helmutheinz2002/analogevse/BOM.ods

AnalogEVSE BOM 1.7
Wert | Bauteile | Anzahl
5n6 | C1 | 1 | X
100n | C2,C5,C6,C8 | 4 | X
220n | C7 | 1 | X
330u/35V | C3,C4 | 2 | X
1u/16V | C9 | 1 | --
1k | R10,R18 | 2 | X
1k/1W | R9 | 1 | --
1k5 | R3 | 1 | X
2k2 | R16,R22 | 2 | X
2k7 | R15 | 1 | X
3k3 | R14 | 1 | X
4k7 | R23,R24,R25 | 3 | X
5k6 | R1 | 1 | --
10k | R2,R6,R7,R8,R11,R21 | 6 | X
15k | R17 | 1 | X
47k | R19,R27 | 2 | X
100k | R4,R5,R20,R26 | 4 | X
1M | R12,R13 | 2 | X
Trimmer 100k | RV1 | 1 | --
Feinsicherung 100mA | F1 | 1 | --
Sicherungshalter | F1 | 1 | --
Relais | K1 | 1 | --
Anschlussklemme 2 Pin | P1,P2,P3,P4,P5 | 5 | X
Anschlussklemme 3 Pin | P6,P7,P8 | 2 | X
Trafo 12V | T1 | 1 | --
DIP 14 Sockel | U1,U4 | 2 | X
1n4002 | D1,D2 | 2 | X
1n4148 | D3,D4,D5,D6,D7,D8 | 6 | X
SD101C | D9 | 1 | X
BC337-40 | Q1,Q2,Q4 | 3 | X
BC557 | Q3 | 1 | X
LM2901 | U1,U4 | 2 | X
LM7812 | U2 | 1 | X
LM7912 | U3 | 1 | X
 |  | 67
