helmutheinz2002/analogevse/Partslist.xls

Bauteile AnalogEVSE
Gesamt: |  | 17.19 |  |  | 18.619 |  | 15.724
Teil | Pollin | Einzelpreis | Info | Reichelt | Einzelpreis | Info | Minimum
P1 | 450 856 | 0.150 |  | AKL 055-02 | 0.310 |  | 0.150
P2 | 450 856 | 0.150 |  | AKL 055-02 | 0.310 |  | 0.150
P3 | 450 856 | 0.150 |  | AKL 055-02 | 0.310 |  | 0.150
P4 | 450 856 | 0.150 |  | AKL 055-02 | 0.310 |  | 0.150
P5 | 450 856 | 0.150 |  | AKL 055-02 | 0.310 |  | 0.150
P6 | 450 856 | 0.150 |  | AKL 055-02 | 0.310 |  | 0.150
P7 | 450 856 | 0.150 |  | AKL 055-02 | 0.310 |  | 0.150
P8 | 450 856 | 0.150 |  | AKL 055-02 | 0.310 |  | 0.150
F1 Halter | 260 305 | 0.250 |  | PTF 18THR | 0.710 |  | 0.250
F1 Sicherung | 260 019 | 0.250 |  | MTR. 0,1A | 0.480 |  | 0.250
T1 | 300 529 | 3.500 | HAHN 08W46, 9V/4.5VA | 421.12-1 | 3.650 | Gerth 4200, 12V, 4.8VA | 3.500
D1 | 140 296 | 0.018 | 1N4002, 10 Stk | 1N 4001 | 0.040 |  | 0.018
D2 | 140 296 | 0.018 |  | 1N 4001 | 0.040 |  | 0.018
D3 | 140 300 | 0.019 | 1N4148, 10 Stk | 1N 4148 | 0.040 |  | 0.019
D4 | 141 300 | 0.019 |  | 1N 4149 | 0.040 |  | 0.019
D5 | 142 300 | 0.019 |  | 1N 4150 | 0.040 |  | 0.019
D6 | 143 300 | 0.019 |  | 1N 4151 | 0.040 |  | 0.019
D7 | 144 300 | 0.019 |  | 1N 4152 | 0.040 |  | 0.019
D8 | 145 300 | 0.019 |  | 1N 4153 | 0.040 |  | 0.019
D9 | 140 382 | 0.030 | SD101C, 10 Stk | BAT 43 | 0.040 |  | 0.030
C1 | 200 166 | 0.100 | 47n | MKS-2 47N | 0.120 |  | 0.100
C5 | 200 166 | 0.100 | 47n | MKS-2 47N | 0.120 |  | 0.100
C8 | 200 166 | 0.100 | 47n | MKS-2 47N | 0.120 |  | 0.100
C2 | 200 776 | 0.060 | 150nF | MKS-2 100N | 0.080 |  | 0.060
C6 | 200 776 | 0.060 | 150nF | MKS-2 100N | 0.080 |  | 0.060
C7 | 200 610 | 0.120 | 220nF | MKS-2 220N | 0.120 |  | 0.120
C3 | 210 046 | 0.180 | 220uF | RAD 220/35 | 0.050 |  | 0.050
C4 | 210 046 | 0.180 | 220uF | RAD 220/35 | 0.050 |  | 0.050
C9 | -- |  | 1uF
K1 | 340 656 | 1.750 | Ab 10 Stk 1.50 | FIN 30.22.9 12V | 1.500 |  | 1.500
Q1 | 130 375 | 0.050 | BC337-40 | BC 549C | 0.040 |  | 0.040
Q2 | 130 375 | 0.050 |  | BC 549C | 0.040 |  | 0.040
Q4 | 130 375 | 0.050 |  | BC 549C | 0.040 |  | 0.040
Q3 | 130 668 | 0.035 | BC557 | BC 557A | 0.040 |  | 0.035
R9 | -- |  |  | 1W 1,0K | 0.154 |  | 0.154
Rx |  | 0.375 |  |  | 0.825 |  | 0.375
RV1 | -- |  |  | 64W-10K | 0.320 |  | 0.320
U1 LM239 | 101 125 | 0.120 |  | LM 2901 DIL | 0.140 |  | 0.120
U1 Sockel | 400 009 | 0.290 |  | GS 14P | 0.230 |  | 0.230
U4 LM239 | 101 125 | 0.120 |  | LM 2901 DIL | 0.140 |  | 0.120
U4 Sockel | 400 009 | 0.290 |  | GS 14P | 0.230 |  | 0.230
Din Gehäuse | 460 147 | 7.500 |  | HUT 6-C | 5.900 |  | 5.900
U2 | 170 176 | 0.280 |  | µA 7812 | 0.270 |  | 0.270
U3 | -- |  |  | µA 7912 | 0.330 |  | 0.330
