helmutheinz2002/analogevse/AnalogEVSE.kicad_pcb

## KiCad design AnalogEVSE.kicad_pcb (2016-09-20)

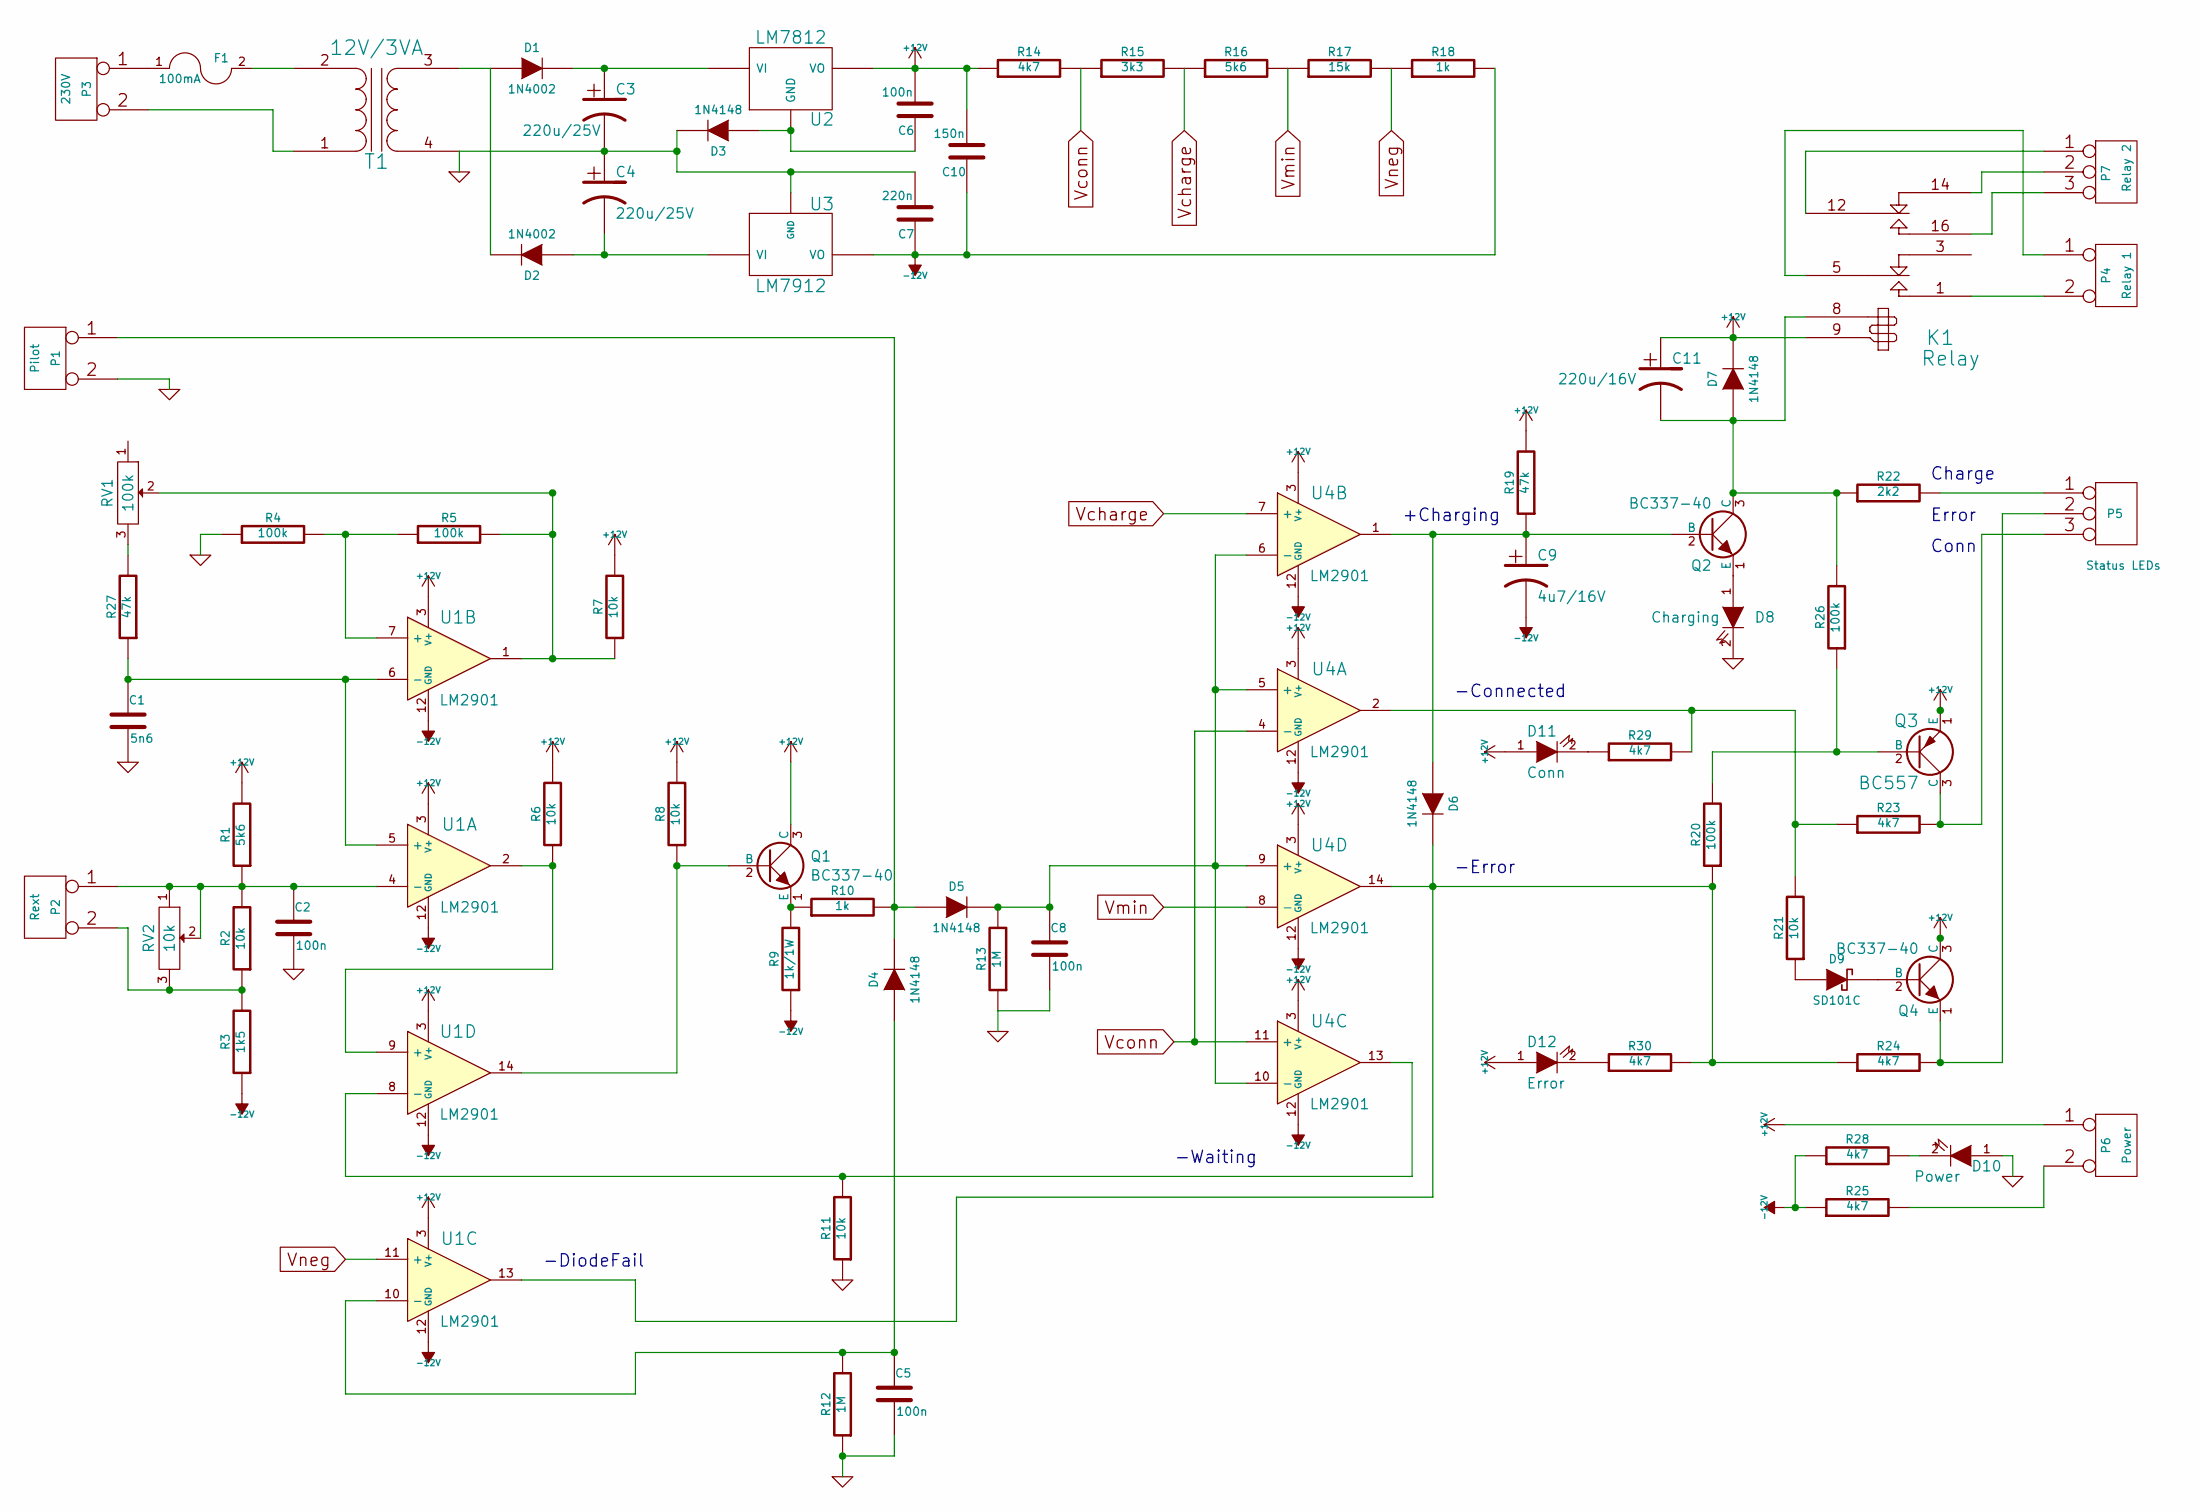
[picture p1: schematic AnalogEVSE.sch]

Parts:
C1: 5n6; C2
C2, C5, C6, C8: 100n; C2
C3, C4: 220u/25V; C5
C7: 220n; C2
C9: 4u7/16V; C6
C10: 150n; C2
C11: 220u/16V; C6
D1, D2: 1N4002; D3-big
D3, D4, D5, D6, D7: 1N4148; D3
D8: Charging; LED-3
D9: SD101C; D3
D10: Power; LED-3
D11: Conn; LED-3
D12: Error; LED-3
F1: 100mA; Fuse-RM9
K1: Relay
P1: Pilot; Term-2pin
P2: Rext; Term-2pin
P3: 230V; Term-2pin
P4: Relay 1; Term-2pin
P5: Status LEDs; Term-3pin
P6: Power; Term-2pin
P7: Relay 2; Term-3pin
Q1, Q2, Q4: BC337-40; TO92
Q3: BC557; TO92
R1, R16: 5k6; R4-LARGE_PADS
R2, R6, R7, R8, R11, R21: 10k; R4-LARGE_PADS
R3: 1k5; R4-LARGE_PADS
R4, R5, R20, R26: 100k; R4-LARGE_PADS
R9: 1k/1W; R8
R10, R18: 1k; R4-LARGE_PADS
R12, R13: 1M; R4-LARGE_PADS
R14, R23, R24, R25, R28, R29, R30: 4k7; R4-LARGE_PADS
R15: 3k3; R4-LARGE_PADS
R17: 15k; R4-LARGE_PADS
R19, R27: 47k; R4-LARGE_PADS
R22: 2k2; R4-LARGE_PADS
RV1: 100k; Trimpot
RV2: 10k; Trimpot3
T1: 12V/3VA; Printtrafo
U1, U4: LM2901; IC-DIP-14
U2: LM7812
U3: LM7912

Connections:
+12V: C6.2, C10.2, C11.1, D7.2 (K), D11.1 (A), D12.1 (A), K1.9, P6.1, Q1.3 (C), Q3.1 (E), Q4.3 (C), R1.2, R6.2, R7.2, R8.2, R14.1, R19.2, U1.3 (V+), U2.VO, U4.3 (V+)
-12V: C7.1, C9.2, C10.1, R3.1, R9.1, R18.2, R25.1, R28.1, U1.12 (GND), U3.VO, U4.12 (GND)
GND: C1.2, C2.2, C3.2, C4.1, C5.2, C7.2, C8.2, D3.2 (K), D8.2 (K), D10.1 (A), P1.2 (PM), R4.1, R11.1, R12.1, R13.1, T1.4 (SB), U3.GND
unnamed: C1.1, R27.1, U1.5 (+), U1.6 (-)
unnamed: C2.1, P2.1, R1.1, R2.2, RV2.1, RV2.2, U1.4 (-)
unnamed: C3.1, D1.2 (K), U2.VI
unnamed: C4.2, D2.1 (A), U3.VI
unnamed: C5.1, D4.1 (A), R12.2, U1.10 (-)
unnamed: C6.1, D3.1 (A), U2.GND
unnamed: C8.1, D5.2 (K), R13.2, U4.5 (+), U4.6 (-), U4.9 (+), U4.10 (-)
unnamed: C9.1, D6.1 (A), Q2.2 (B), R19.1, U4.1
unnamed: D1.1 (A), D2.2 (K), T1.3 (SA)
unnamed: D4.2 (K), D5.1 (A), P1.1, R10.2
unnamed: D6.2 (K), R20.1, R24.1, R30.2, U1.13, U4.14
unnamed: C11.2, D7.1 (A), K1.8, Q2.3 (C), R22.1, R26.2
unnamed: D8.1 (A), Q2.1 (E)
unnamed: D9.1 (A), R21.1
unnamed: D9.2 (K), Q4.2 (B)
unnamed: D10.2 (K), R28.2
unnamed: D11.2 (K), R29.1
unnamed: D12.2 (K), R30.1
unnamed: F1.1, P3.1
unnamed: F1.2, T1.2 (AB)
unnamed: K1.1 (T1), P4.2 (PM)
unnamed: K1.5 (C1), P4.1
unnamed: K1.12 (C2), P7.1
unnamed: K1.14 (R2), P7.2 (PM)
unnamed: K1.16 (T2), P7.3
unnamed: P2.2 (PM), R2.1, R3.2, RV2.3
unnamed: P3.2 (PM), T1.1 (AA)
unnamed: P5.1, R22.2
unnamed: P5.2 (PM), Q4.1 (E), R24.2
unnamed: P5.3, Q3.3 (C), R23.2
unnamed: P6.2 (PM), R25.2
unnamed: Q1.1 (E), R9.2, R10.1
unnamed: Q1.2 (B), R8.1, U1.14
unnamed: Q3.2 (B), R20.2, R26.1
unnamed: R4.2, R5.1, U1.7 (+)
unnamed: R5.2, R7.1, RV1.2, U1.1
unnamed: R6.1, U1.2, U1.9 (+)
unnamed: R11.2, U1.8 (-), U4.13
unnamed: R21.2, R23.1, R29.2, U4.2
unnamed: R27.2, RV1.3
Vcharge: R15.2, R16.1, U4.7 (+)
Vconn: R14.2, R15.1, U4.4 (-), U4.11 (+)
Vmin: R16.2, R17.1, U4.8 (-)
Vneg: R17.2, R18.1, U1.11 (+)

Notes on the sheet:
-DiodeFail
+Charging
-Connected
-Error
-Waiting
Conn
Charge
Error

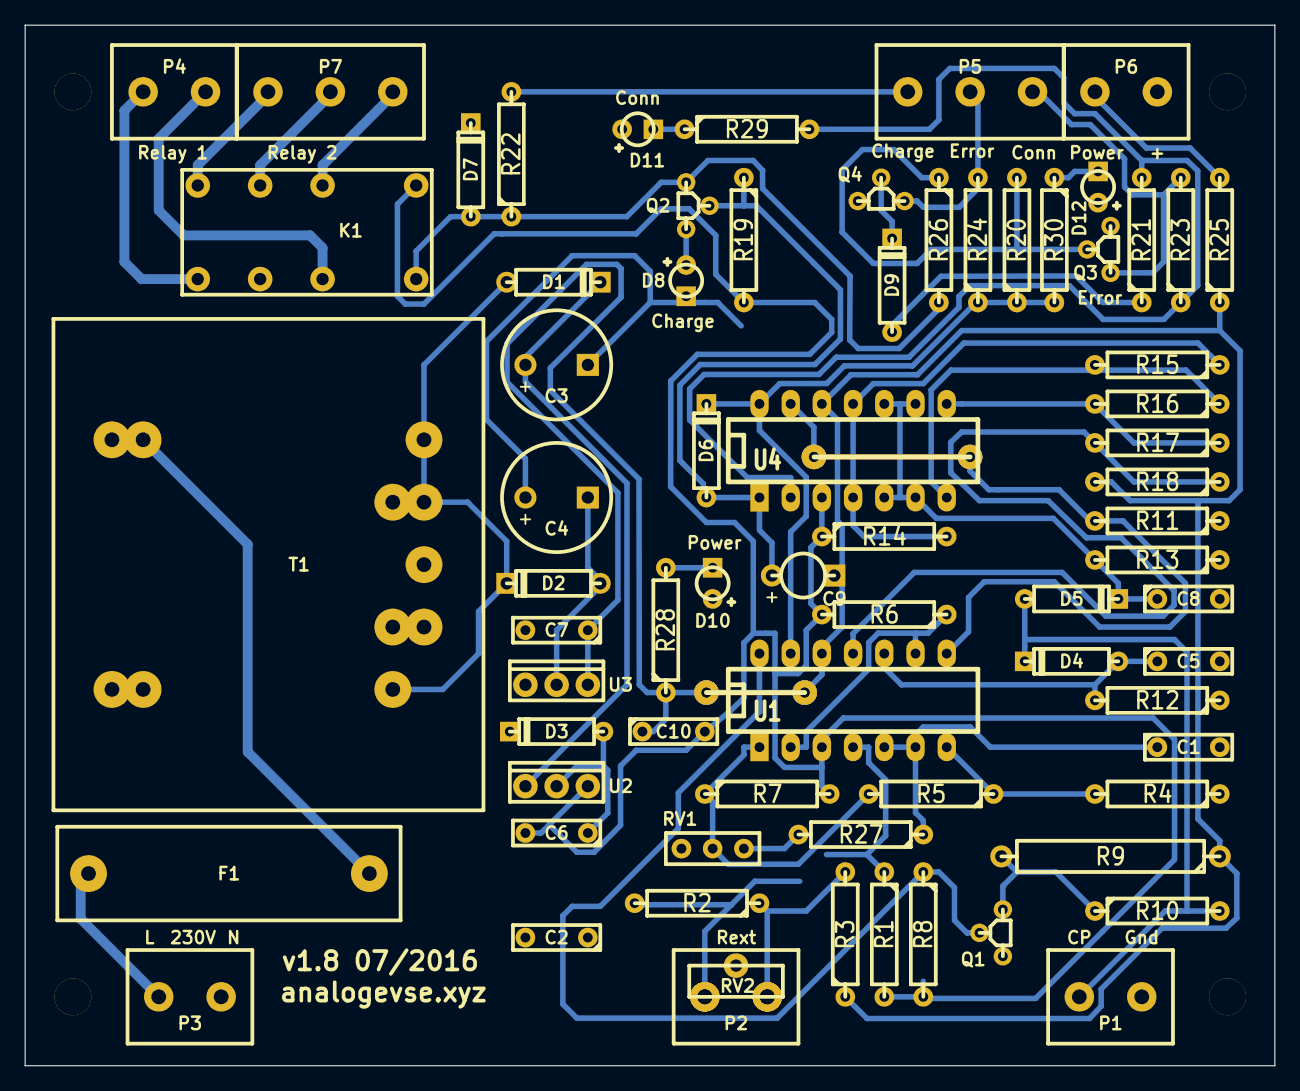
[picture p2: board AnalogEVSE.kicad_pcb from above]

Board: 2 copper layers, 101.7 x 84.7 mm, 72 parts (0 on the bottom side), 47 nets.
