helmutheinz2002/analogevse/Anleitung.odt

# AnalogEVSE Bauanleitung

07/2016 v1.8

## Allgemeine Hinweise

Dieser Bausatz enthält alle Bauteile, die für den Bau und Test der AnalogEVSE Ladesteuerung benötigt werden. Das Bestücken der Platine erfordert ein gewisses Maß an Erfahrung im Umgang mit dem Lötkolben. Falsch eingelötete Bauteile oder Lötzinnrückstände auf der Platine führen zu Fehl- oder Nichtfunktion. Sauberes und sorgfältiges Arbeiten ist daher sehr wichtig. Bitte lesen Sie diese Anleitung durch, bevor Sie mit dem Zusammenbau beginnen.

Details zur Schaltung gibt es unter analogevse.xyz

## Sicherheitshinweis

Bei dieser Schaltung befinden sich 230V Netzspannung und Niederspannung auf der selben Platine. Ist die Schaltung mit dem Stromnetz verbunden, ist daher beim Hantieren mit der Platine äußerste Vorsicht geboten.

## Werkzeug

Folgende Werkzeuge und Geräte werden benötigt:

- ein feiner Lötkolben und dünnes Lötzinn
- ein Seitenschneider
- evtl. eine kleine Zange zum Zurechtbiegen von Anschlussdrähten
- ein Multimeter
- ein Oszilloskop oder Frequenzzähler, alternativ ein Intrument oder Stimmgerät

## Vorbereitung

Prüfen Sie anhand der Stückliste die Vollständigkeit der Bauteile und identifizieren Sie die einzelnen Komponenten.

Hinweis: R9 (1k/1W) hat einen grünen Körper, D9 hat Klebestreifen an den Beinchen

## Zusammenbau

### Allgemeine Hinweise

Grundsätzlich empfiehlt sich beim Zusammenbau der Steuerung folgendes Vorgehen:

- Bestücken und Test des Netzteils
- Bestücken und Test der Steuerung
- Einbau ins Hutschienengehäuse

Alle Bauteile sollten so eingelötet werden, dass sie möglichst fest auf der Platine aufliegen und kein Spiel haben. Eine Ausnahme bilden die Transistoren und Spannungsregler. Ihre Beinchen sollten in eingelötetem Zustand etwa 7mm lang sein.

### Bestücken und Test des Netzteils

Bauteile: P1, P3, F1, T1, D1, D2, D3, D10, C3, C4, C6, C7, C10, R28, U2, U3

Die Platine besitzt Löcher für verschiedene Trafotypen. Zuerst wird der Trafo in die passenden Löcher eingesetzt und verlötet.. Bei Dioden und Elkos muss die Polarität beachtet werden. Die Spannungsregler U2 und U3 zeigen mit der Vorderseite in Richtung Netzanschluss (P3).

Sind alle o.g. Teile eingelötet, wird die Sicherung eingesetzt und die Platine mit 230V~ verbunden. Die Power LED leuchtet und zwischen 0V (P1 Gnd) und Pin 3 der IC Sockel müssen jetzt +12,8V messbar sein, zwischen 0V und Pin 12 der Sockel -12V. Ist dies nicht der Fall, sofort ausschalten und den Fehler suchen.

- Gibt es Lötzinnbrücken auf der Platine?
- Ist die Sicherung eingesetzt und noch ganz?
- Ist an der Sekundärseite des Trafos eine Wechselspannung messbar?
- Sind die Dioden und die Elkos richtig herum eingesetzt?
- Ist an den Pins der Elkos eine Gleichspannung messbar?
- Sind die Spannungsregler richtig herum eingesetzt?
- Sind die Spannungsregler vertauscht?

### Bestücken und Test der Steuerung

Zuerst werden die Dioden D4 und D5 bestückt. Die abgeschnittenen Anschlussdrähte werden für die beiden Drahtbrücken verwendet und die IC Sockel darüber eingelötet. Danach werden die Anschlussklemmen und das Relais eingesetzt. Die Anschlussklemmen P5 und P6 müssen so eingesetzt werden, dass beim Bestücken die seitlichen Führungen ineinander greifen und die Klemmen nahtlos verbinden. Es folgen alle Widerstände, die Kondensatoren, die restlichen Dioden, das Trimmpoti und zuletzt die Transistoren. Das Trimmpoti sollte auf einen Wert von ca. 32KΩ voreingestellt werden. Sind alle Teile verlötet, werden U1 und U4 in die Sockel gesteckt. Hierzu müssen die Beinchen ein wenig nach innen gebogen werden.

Nach einer sorgfältigen Kontrolle wird die Steuerung mit dem Stromnetz verbunden. Jetzt sollten nur die Power und die Error LED auf der Platine leuchten. Leuchten auch andere LEDs, liegt ein Fehler vor.

Tips zur Fehlersuche:

- Gibt es Lötzinnbrücken auf der Platine?
- Liegt die Versorgungsspannung an?
- Sind die Dioden an der richtigen Stelle und richtig herum eingesetzt?
- Sind die Transistoren an der richtigen Stelle?
- Sind die ICs richtig herum eingesetzt?

## Abgleich des Oszillators

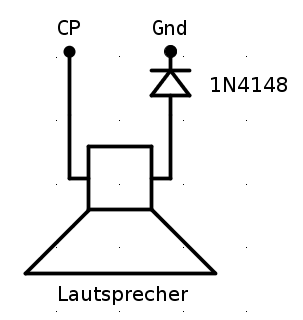
[picture p3: figure]

Bedingt durch Bauteiltoleranzen ist es leider nicht möglich, die Frequenz des Oszillators mit ausreichender Genauigkeit auf 1kHz voreinzustellen. Daher muss mit Hilfe des Trimmpotis RV1 der Oszillator auf 1kHz abgeglichen werden. Mit einem Oszilloskop oder einem Frequenzzähler wird an Pin 2 von U1 das Signal abgegriffen und RV1 so lange verstellt, bis die Frequenz bei 1kHz liegt.

Stehen die benötigten Messgeräte nicht zur Verfügung, kann der Abgleich akustisch durchgeführt werden. Hierzu werden eine Diode und ein Lautsprecher wie unten abgebildet an die Pilotsignal-Anschlussklemmen angeschlossen. Wird die Ladesteuerung eingeschaltet, ist im Lautsprecher ein Pfeifton hörbar. Dieser Ton kann nun mit einem Instrument (z.B. Klavier) verglichen werden und muss zwischen h'' und c''' liegen. Ein Stimmgerät kann hierbei hilfreich sein. Alternativ kann die Frequenz auch mit einer Oszilloskop oder Spectrum Analyzer App kontrolliert werden.

Ist die Frequenz nicht korrekt eingestellt, reagiert das Auto evtl. nicht oder nicht richtig auf das Pilotsignal.

## Test der Steuerung

Die LEDs auf der Platine dienen der Kontrolle und Fehlersuche. Anders als bei den extern angeschlossenen LEDs, bei denen jeweils nur eine LED leuchtet, können bei den Kontroll-LEDs mehrere gleichzeitig an sein. Dies vereinfacht die Schaltung und reicht für Testzwecke aus. Folgende Zustände werden angezeigt:

State | Conn LED | Charge LED | Error LED
No EV / Idle | Aus | Aus | An
EV Connected | An | Aus | Aus
EV Charging | An | An | Aus
Error - Pilot Kurzschluss | An | Aus | An
Error - Diodenfehler | An/Aus | Aus | An

Der EV-Simulator und die Testprozedur sind auf analogevse.xyz beschrieben.

## Einbau ins Gehäuse

Funktioniert die Steuerung wie gewünscht, kann sie in das Hutschienengehäuse eingesetzt werden.

## Einstellen des Ladestroms

Der Ladestrom wird durch den externen Widerstand an P2 festgelegt. Ist kein Widerstand angeschlossen, liegt der Ladestrom bei 8A. Mit einem Umschalter können verschiedene Widerstände geschaltet und so zwischen mehreren Ladeströmen gewählt werden. Statt fester Widerstände kann natürlich auch ein Poti verwendet werden. Hierbei ist zu beachten, dass der Zusammenhang zwischen Widerstand und Ladestrom nicht linear ist.

Ladestrom | Rext | | Ladestrom | Rext
8A | - | | 34A | 4k7
12A | 47k | | 36A | 3k9
14A | 33k | | 39A | 3k3
16A | 27k | | 42A | 2k7
18A | 22k | | 44A | 2k2
20A | 15k | | 48A | 1k5
24A | 10k | | 52A | 1k2
30A | 6k8 | | 62A | 1k

## Stückliste

Wert | Bauteile | Anzahl
5n6 | C1 | 1
100n | C2,C5,C6,C8 | 4
150n | C10 | 1
220n | C7 | 1
4u7/16V | C9 | 1
330u/35V | C3,C4 | 2
1k | R10,R18 | 2
1k/1W | R9 | 1
1k5 | R3 | 1
2k2 | R22 | 1
3k3 | R15 | 1
4k7 | R14,R23,R24,R25,R28,R29,R30 | 7
5k6 | R1,R16 | 2
10k | R2,R6,R7,R8,R11,R21 | 6
15k | R17 | 1
47k | R19,R27 | 2
100k | R4,R5,R20,R26 | 4
1M | R12,R13 | 2
Trimmer 100k | RV1 | 1
Trimmer 10k | RV2 (optional) | 1
Feinsicherung 100mA | F1 | 1
Sicherungshalter | F1 | 1
Relais | K1 | 1
Anschlussklemme 2 Pin | P1,P2,P3,P4,P6 | 5
Anschlussklemme 3 Pin | P5,P7 | 2
Trafo 12V | T1 | 1
DIP 14 Sockel | U1,U4 | 2
1n4002 | D1,D2 | 2
1n4148 | D3,D4,D5,D6,D7 | 5
SD101C | D9 | 1
BC337-40 | Q1,Q2,Q4 | 3
BC557 | Q3 | 1
LM2901 | U1,U4 | 2
LM7812 | U2 | 1
LM7912 | U3 | 1
LED 3mm gelb | D10,D11 | 2
LED 3mm rot | D12 | 1
LED 3mm grün | D8 | 1
