helmutheinz2002/analogevse/(commit log)

2016-06-05 Filter caps
    [AnalogEVSE.sch]
2016-09-20 Addition of C11
    [AnalogEVSE.kicad_pcb, AnalogEVSE.sch, BOM.ods, Partslist.xls]
